orange-dot/mamut-epm-hw-/bench/README.md

# Bench Workspace

This directory holds physical prototype evidence.

Use it for:

- measurement notes
- scope screenshots
- drift logs
- calibration notes
- photos that explain a real hardware issue

Do not mix simulation outputs into this area.

The rule is simple:

- `sim/` explains what we expected
- `bench/` records what reality did
