orange-dot/mamut-epm-hw-/hardware/p1-vco/bom/supplier-rfq-email-sr.md

# RFQ Email: P1 / P1D Components

Subject: Upit za ponudu - elektronske komponente

Postovani,

Molim ponudu za stavke ispod.

Za svaku stavku navedite proizvodjaca, tacnu oznaku, kuciste, dostupnu
kolicinu, cenu i rok isporuke. Ako tacna stavka nije dostupna, navedite
najblizu zamenu.

Preferencija: THT gde je dostupno. Ako je dostupno samo SMD, navedite kuciste.

## A. Osnovna lista

### Otpornici

Metal-film, 1%, 0.25 W ili slicno.

| Vrednost | Kolicina |
| --- | ---: |
| 10R | 10 kom |
| 22R | 10 kom |
| 100R | 10 kom |
| 220R | 10 kom |
| 330R | 10 kom |
| 1k | 10 kom |
| 4k7 | 10 kom |
| 5k6 | 10 kom |
| 10k | 20 kom |
| 11k | 10 kom |
| 47k | 10 kom |
| 100k | 20 kom |
| 220k | 10 kom |
| 330k | 10 kom |
| 1M | 10 kom |
| 4M7 | 10 kom |
| 10M | 10 kom |

### Trimeri / potenciometri

Multiturn, THT.

| Vrednost | Kolicina |
| --- | ---: |
| 2k | 2 kom |
| 10k | 2 kom |
| 20k | 2 kom |
| 100k | 2 kom |

### Kondenzatori

Za male vrednosti C0G/NP0 gde je dostupno.

| Vrednost | Kolicina |
| --- | ---: |
| 10pF C0G/NP0 | 5 kom |
| 22pF C0G/NP0 | 5 kom |
| 33pF C0G/NP0 | 5 kom |
| 47pF C0G/NP0 | 5 kom |
| 100pF C0G/NP0 | 5 kom |
| 220pF C0G/NP0 | 5 kom |
| 1nF C0G/NP0 ili film | 5 kom |
| 2.2nF C0G/film | 5 kom |
| 4.7nF C0G/film | 5 kom |
| 10nF C0G/film | 5 kom |
| 100nF ceramic | 20 kom |
| 1uF | 10 kom |
| 10uF | 10 kom |

### Poluprovodnici i IC

| Deo | Kolicina |
| --- | ---: |
| LM311, DIP8 ili kompatibilan comparator | 2 kom |
| TL071, DIP8 | 2 kom |
| TL072, DIP8 | 2 kom |
| 2N3904, TO-92 ili ekvivalent NPN | 25 kom |
| 2N3906, TO-92 ili ekvivalent PNP | 10 kom |
| 1N4148 ili 1N914 | 25 kom |
| Zener 4.7V | 5 kom |
| Zener 5.1V | 5 kom |
| Zener 6.2V | 5 kom |
| Zener 9.1V | 5 kom |

### Posebni analogni delovi

| Deo | Kolicina |
| --- | ---: |
| 2k 3300ppm/C tempco resistor | 2 kom |
| matched NPN transistor pair, npr. SSM2212/MAT12 ili slicno | 1-3 kom |
| JFET, npr. J201 / 2N5457 / BF245 ili slicno | 5 kom |

### Konektori, socket-i, test point-i

| Deo | Kolicina |
| --- | ---: |
| Pin header 1x03, 2.54mm | 5 kom |
| Pin header 1x05, 2.54mm | 5 kom |
| Pin header strip 2.54mm | 2-5 kom |
| IC socket DIP8 | 5 kom |
| TO-92 socket ili pin socket strip | nekoliko |
| test point pinovi / turret / loop test points | 20+ kom |
| prototipska plocica, perfboard ili stripboard | 2-3 kom |
| zica za povezivanje, solid core | 1-2 kotura |

## B. Full-discrete dodatak

Ako su ove stavke vec pokrivene u listi A, navedite samo dodatne kolicine.

### Tranzistori, diode, zeneri

| Deo | Dodatna kolicina |
| --- | ---: |
| 2N3904, TO-92 ili ekvivalent NPN | +60 kom |
| 2N3906, TO-92 ili ekvivalent PNP | +35 kom |
| 1N4148 ili 1N914 | +50 kom |
| JFET, npr. J201 / 2N5457 / BF245 ili slicno | +5 kom |
| Zener 4.7V | +5 kom |
| Zener 5.1V | +5 kom |
| Zener 6.2V | +5 kom |
| Zener 9.1V | +5 kom |

### Dodatni otpornici

Metal-film, 1%, 0.25 W ili slicno.

| Vrednost | Dodatna kolicina |
| --- | ---: |
| 100R | +10 kom |
| 1k | +10 kom |
| 10k | +20 kom |
| 47k | +10 kom |
| 100k | +20 kom |
| 330k | +10 kom |
| 4M7 | +10 kom |

### Dodatni kondenzatori

| Vrednost | Dodatna kolicina |
| --- | ---: |
| 100pF C0G/NP0 | +5 kom |
| 220pF C0G/NP0 | +5 kom |
| 1nF C0G/film | +5 kom |
| 2.2nF C0G/film | +5 kom |
| 4.7nF C0G/film | +5 kom |
| 10nF C0G/film | +5 kom |

### Dodatni pribor

| Deo | Kolicina |
| --- | ---: |
| test point pinovi / turret / loop test points | +20 kom |
| male krokodil/logic hook sonde | 5-10 kom |
| kratke zice / jumperi | 1 pak |
| heat-shrink buzir, mali precnici | 1 pak |
| termalna pasta ili termalni lepak | 1 kom |

## C. Napajanje i merenje

| Oprema | Kolicina | Minimalna specifikacija |
| --- | ---: | --- |
| laboratorijsko napajanje | 1 kom | dual rail ili resenje za +12V / -12V |
| osciloskop | 1 kom | 2 kanala minimum, 4 kanala pozeljno, 50-100MHz |
| multimetar | 1 kom | DC napon/otpor |
| LCR/component tester | 1 kom | opciono |

Hvala unapred.

Pozdrav,

[ime]
