orange-dot/mamut-epm-hw-/hardware/p1-vco/kicad/p1-bench-io.kicad_sch

## KiCad design hardware/p1-vco/kicad/p1-bench-io.kicad_sch (2026-04-27)

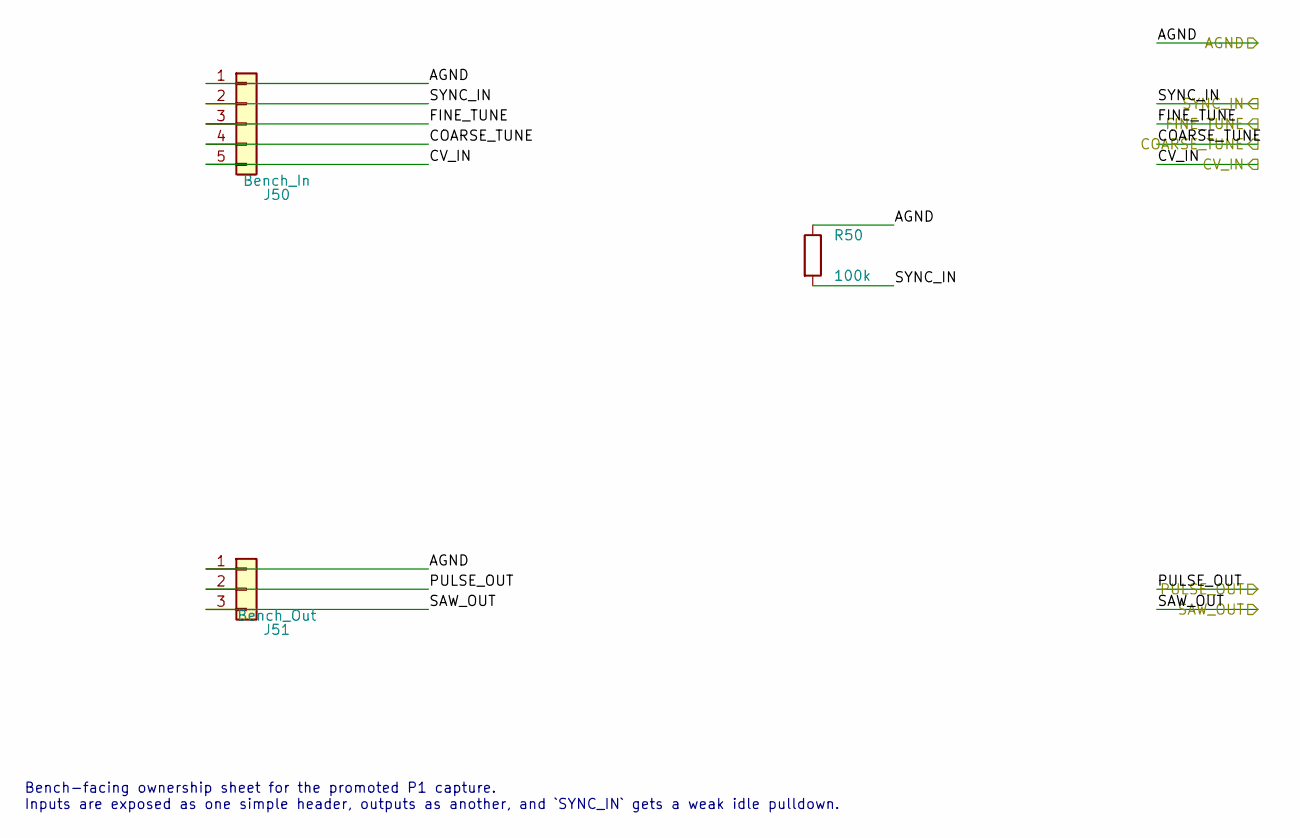
[picture p1: schematic p1-bench-io.kicad_sch]

Parts:
J50: Bench_In; PinHeader_1x05_P2.54mm_Vertical
J51: Bench_Out; PinHeader_1x03_P2.54mm_Vertical
R50: 100k

Connections:
AGND: J50.1, J51.1, R50.1
COARSE_TUNE: J50.4
CV_IN: J50.5
FINE_TUNE: J50.3
PULSE_OUT: J51.2
SAW_OUT: J51.3
SYNC_IN: J50.2, R50.2

Notes on the sheet:
Bench-facing ownership sheet for the promoted P1 capture. Inputs are exposed as one simple header, outputs as another, and `SYNC_IN` gets a weak idle pulldown.
