orange-dot/mamut-epm-hw-/hardware/p1-vco/kicad/p1-current-integrator.kicad_sch

## KiCad design hardware/p1-vco/kicad/p1-current-integrator.kicad_sch (2026-04-27)

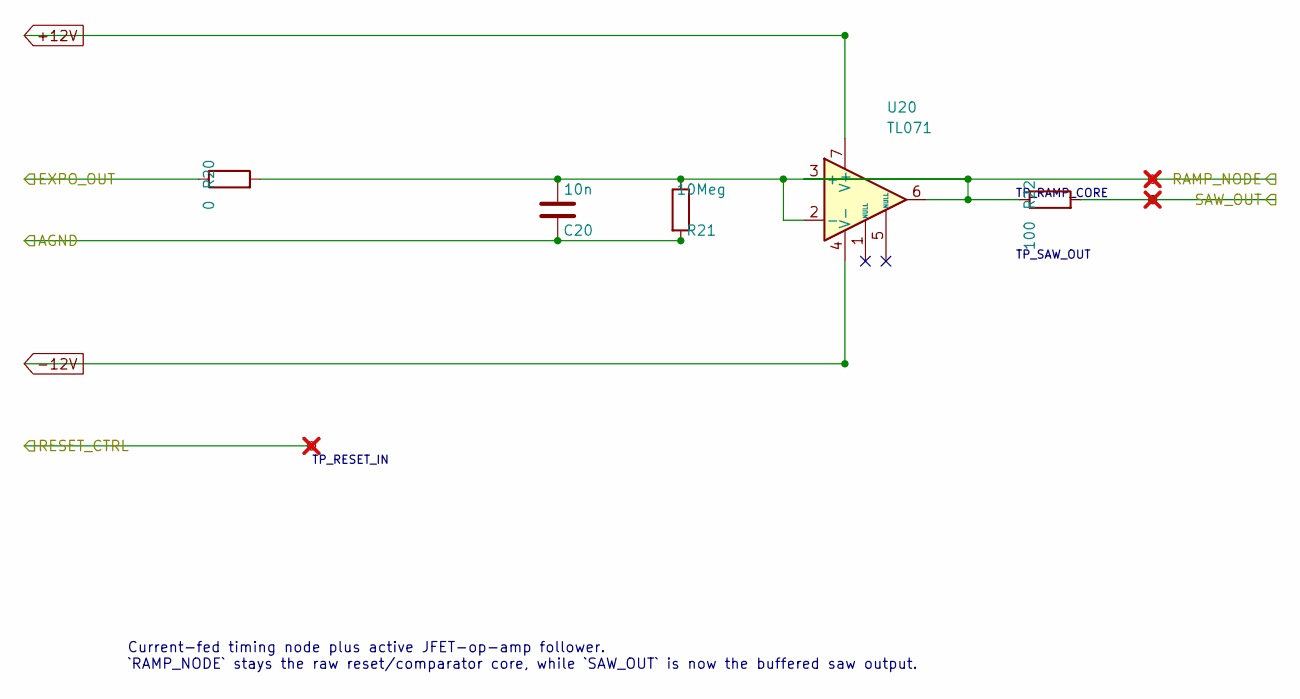
[picture p2: schematic p1-current-integrator.kicad_sch]

Parts:
C20: 10n
R20: 0
R21: 10Meg
R22: 100
TP20, TP21, TP22: TestPoint; TestPoint_Pad_D2.0mm; not fitted
U20: TL071

Connections:
+12V: U20.7 (V+)
-12V: U20.4 (V-)
AGND: C20.2, R21.2
EXPO_OUT: R20.1
RAMP_NODE: C20.1, R20.2, R21.1, R22.1, TP20.1, U20.2 (-), U20.3 (+), U20.6
RESET_CTRL: TP21.1
SAW_OUT: R22.2, TP22.1

Notes on the sheet:
Current-fed timing node plus active JFET-op-amp follower. `RAMP_NODE` stays the raw reset/comparator core, while `SAW_OUT` is now the buffered saw output.
TP_RAMP_CORE
TP_SAW_OUT
TP_RESET_IN
