orange-dot/mamut-epm-hw-/hardware/p1-vco/kicad/p1-expo-converter.kicad_sch

## KiCad design hardware/p1-vco/kicad/p1-expo-converter.kicad_sch (2026-05-07)

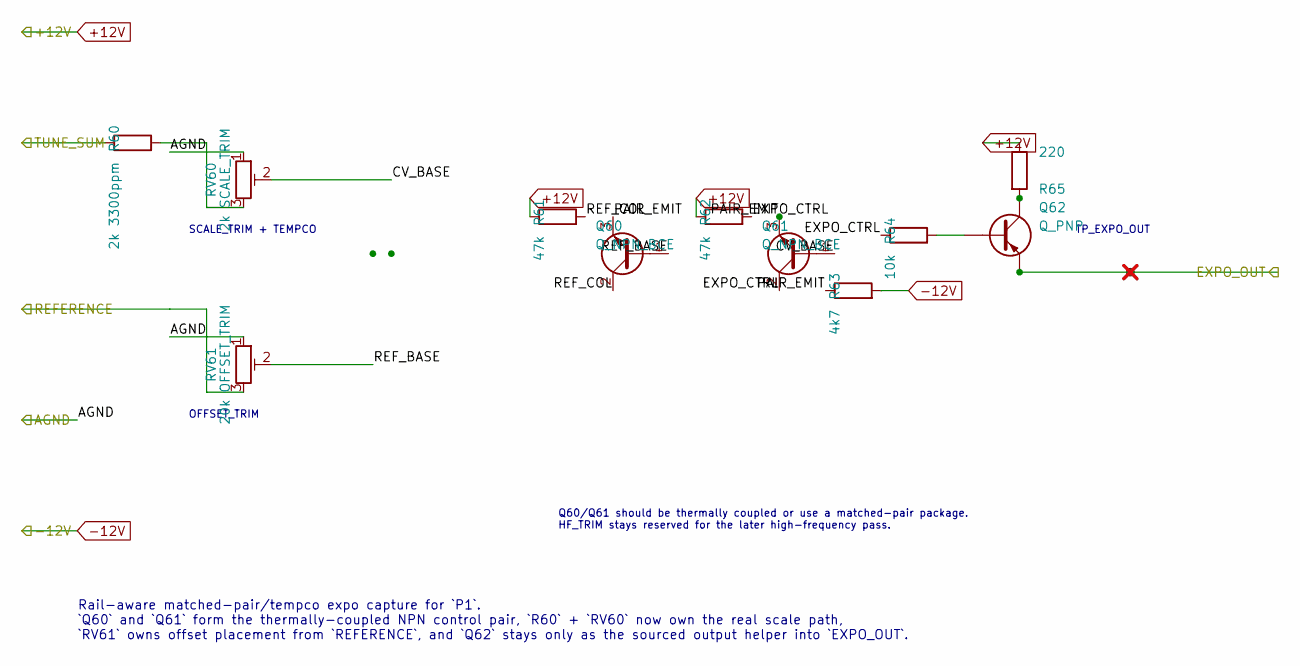
[picture p3: schematic p1-expo-converter.kicad_sch]

Parts:
Q60, Q61: Q_NPN_BCE
Q62: Q_PNP
R60: 2k 3300ppm
R61, R62: 47k
R63: 4k7
R64: 10k
R65: 220
RV60: 2k SCALE_TRIM
RV61: 20k OFFSET_TRIM
TP60: TestPoint; TestPoint_Pad_D2.0mm; not fitted

Connections:
+12V: R61.1, R62.1, R65.1
-12V: R63.2
AGND: RV60.1, RV61.1
CV_BASE: Q61.1 (B), RV60.2
EXPO_CTRL: Q61.2 (C), R62.2, R64.1
EXPO_OUT: Q62.E, TP60.1
unnamed: Q62.B, R64.2
unnamed: Q62.C, R65.2
unnamed: R60.2, RV60.3
PAIR_EMIT: Q60.3 (E), Q61.3 (E), R63.1
REFERENCE: RV61.3
REF_BASE: Q60.1 (B), RV61.2
REF_COL: Q60.2 (C), R61.2
TUNE_SUM: R60.1

Notes on the sheet:
Rail-aware matched-pair/tempco expo capture for `P1`. `Q60` and `Q61` form the thermally-coupled NPN control pair, `R60` + `RV60` now own the real scale path, `RV61` owns offset placement from `REFERENCE`, and `Q62` stays only as the sourced output helper into `EXPO_OUT`.
SCALE_TRIM + TEMPCO
OFFSET_TRIM
Q60/Q61 should be thermally coupled or use a matched-pair package. HF_TRIM stays reserved for the later high-frequency pass.
TP_EXPO_OUT
