orange-dot/mamut-epm-hw-/hardware/p1-vco/kicad/p1-input-tune.kicad_sch

## KiCad design hardware/p1-vco/kicad/p1-input-tune.kicad_sch (2026-04-27)

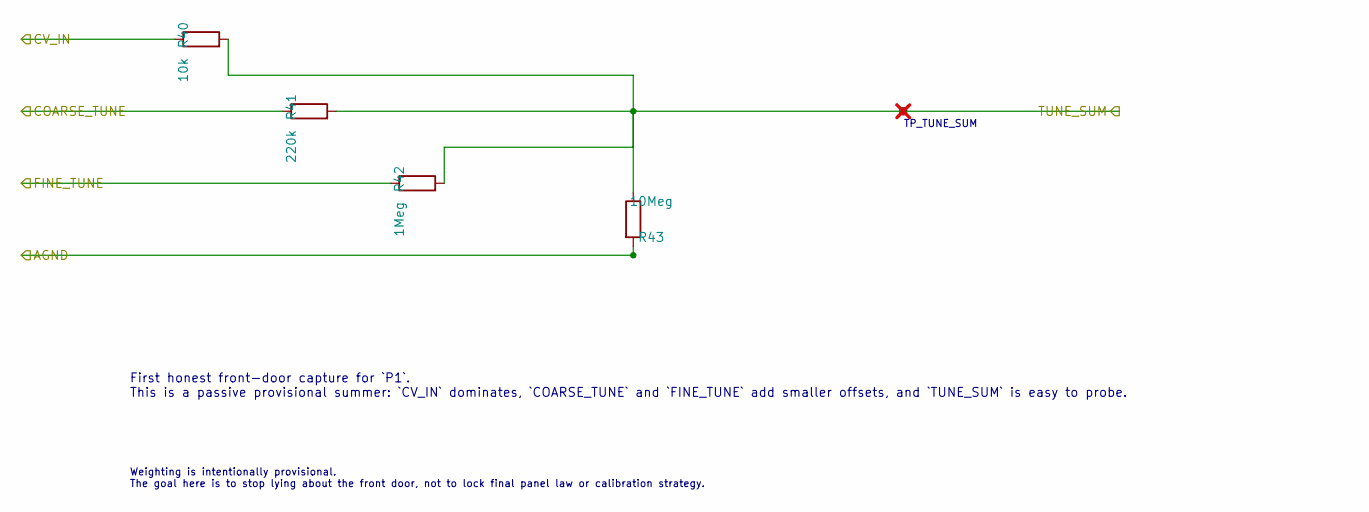
[picture p4: schematic p1-input-tune.kicad_sch]

Parts:
R40: 10k
R41: 220k
R42: 1Meg
R43: 10Meg
TP40: TestPoint; TestPoint_Pad_D2.0mm; not fitted

Connections:
AGND: R43.2
COARSE_TUNE: R41.1
CV_IN: R40.1
FINE_TUNE: R42.1
TUNE_SUM: R40.2, R41.2, R42.2, R43.1, TP40.1

Notes on the sheet:
First honest front-door capture for `P1`. This is a passive provisional summer: `CV_IN` dominates, `COARSE_TUNE` and `FINE_TUNE` add smaller offsets, and `TUNE_SUM` is easy to probe.
Weighting is intentionally provisional. The goal here is to stop lying about the front door, not to lock final panel law or calibration strategy.
TP_TUNE_SUM
