orange-dot/mamut-epm-hw-/hardware/p1-vco/kicad/p1-power-reference.kicad_sch

## KiCad design hardware/p1-vco/kicad/p1-power-reference.kicad_sch (2026-04-27)

Schematic: p1-power-reference.kicad_sch

Parts:
C30, C31, C32: 100n
R30: 11k
R31: 1k
TP30, TP31, TP32, TP33: TestPoint; TestPoint_Pad_D2.0mm; not fitted

Notes on the sheet:
Bench-fed analog support sheet. Right now this does not own the final PSU architecture. It owns rail vocabulary, light local decoupling, and a low-impedance `REFERENCE` node for the current threshold studies.
Nominal `REFERENCE` target is about 1.0 V from the `+12 V` rail. The divider is intentionally low-impedance so the current `R10 = 100k` threshold load does not bend it badly. Trimmed or buffered reference work can come later.
TP_+12V
TP_-12V
TP_AGND
TP_REF
