orange-dot/mamut-epm-hw-/hardware/p1-vco/kicad/p1-reset-output.kicad_sch

## KiCad design hardware/p1-vco/kicad/p1-reset-output.kicad_sch (2026-04-27)

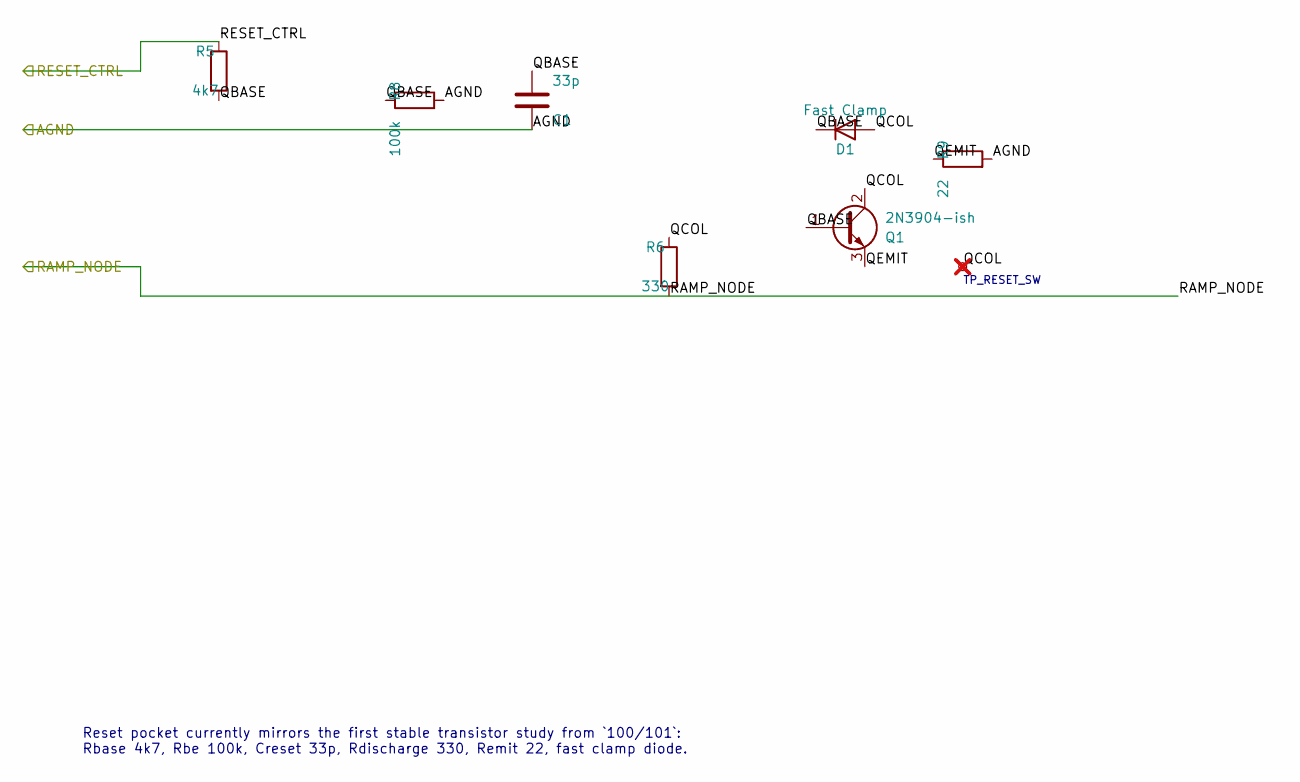
[picture p5: schematic p1-reset-output.kicad_sch]

Parts:
C1: 33p
D1: Fast Clamp
Q1: 2N3904-ish
R5: 4k7
R6: 330
R8: 100k
R9: 22
TP4: TestPoint; TestPoint_Pad_D2.0mm; not fitted

Connections:
AGND: C1.2, R8.2, R9.2
QBASE: C1.1, D1.1 (K), Q1.1 (B), R5.2, R8.1
QCOL: D1.2 (A), Q1.2 (C), R6.1, TP4.1
QEMIT: Q1.3 (E), R9.1
RAMP_NODE: R6.2
RESET_CTRL: R5.1

Notes on the sheet:
Reset pocket currently mirrors the first stable transistor study from `100/101`: Rbase 4k7, Rbe 100k, Creset 33p, Rdischarge 330, Remit 22, fast clamp diode.
TP_RESET_SW
