orange-dot/mamut-epm-hw-/hardware/p1-vco/kicad/p1-threshold-comparator.kicad_sch

## KiCad design hardware/p1-vco/kicad/p1-threshold-comparator.kicad_sch (2026-04-27)

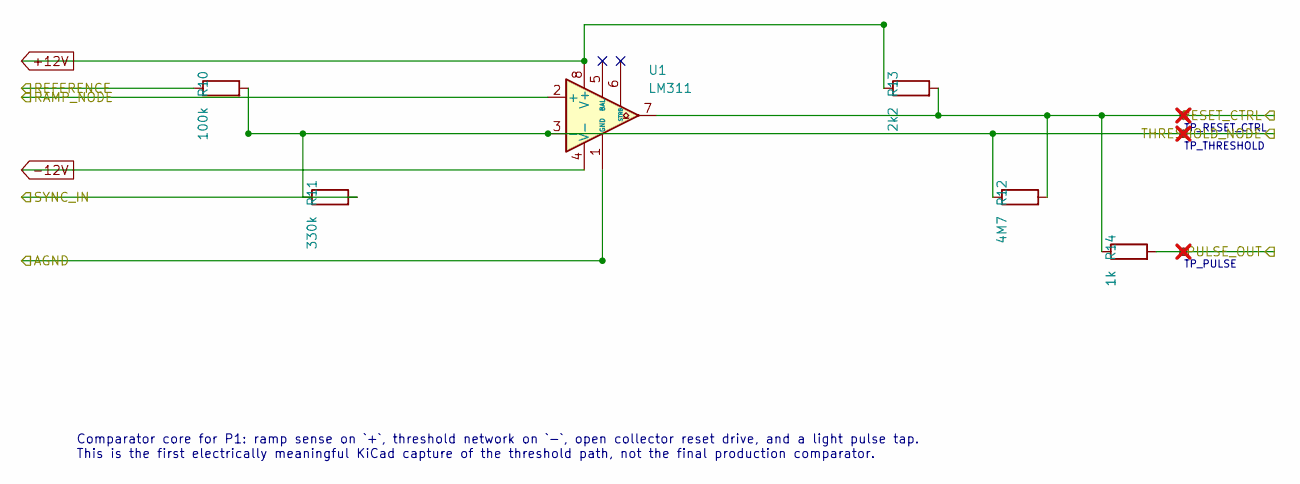
[picture p6: schematic p1-threshold-comparator.kicad_sch]

Parts:
R10: 100k
R11: 330k
R12: 4M7
R13: 2k2
R14: 1k
TP1, TP2, TP3: TestPoint; TestPoint_Pad_D2.0mm; not fitted
U1: LM311

Connections:
+12V: R13.1, U1.8 (V+)
-12V: U1.4 (V-)
AGND: U1.1 (GND)
PULSE_OUT: R14.2, TP3.1
RAMP_NODE: U1.2 (+)
REFERENCE: R10.1
RESET_CTRL: R12.2, R13.2, R14.1, TP2.1, U1.7
SYNC_IN: R11.2
THRESHOLD_NODE: R10.2, R11.1, R12.1, TP1.1, U1.3 (-)

Notes on the sheet:
Comparator core for P1: ramp sense on `+`, threshold network on `-`, open collector reset drive, and a light pulse tap. This is the first electrically meaningful KiCad capture of the threshold path, not the final production comparator.
TP_THRESHOLD
TP_RESET_CTRL
TP_PULSE
