orange-dot/mamut-epm-hw-/(commit log)

2026-04-27 Publish initial EPM2 hardware lab
    [mamut-p1-vco.kicad_sch, p1-bench-io.kicad_sch, p1-current-integrator.kicad_sch, p1-expo-converter.kicad_sch, p1-input-tune.kicad_sch, p1-power-reference.kicad_sch, p1-reset-output.kicad_sch, p1-threshold-comparator.kicad_sch]
2026-05-07 Refresh P1 VCO KiCad ERC report
    [p1-expo-converter.kicad_sch]
2026-06-29 docs: P1D full discrete VCO line and BOM; extend study workflow
    Adds docs/p1d-full-discrete-vco-line.md with full discrete VCO design
    notes. Adds hardware/p1-vco/bom/ directory. Updates p1-study-workflow
    and p1-discrete-vco-prototype docs.
